mjmokhtar/STM32F407VETx-EC600K-IoT/images/image.png

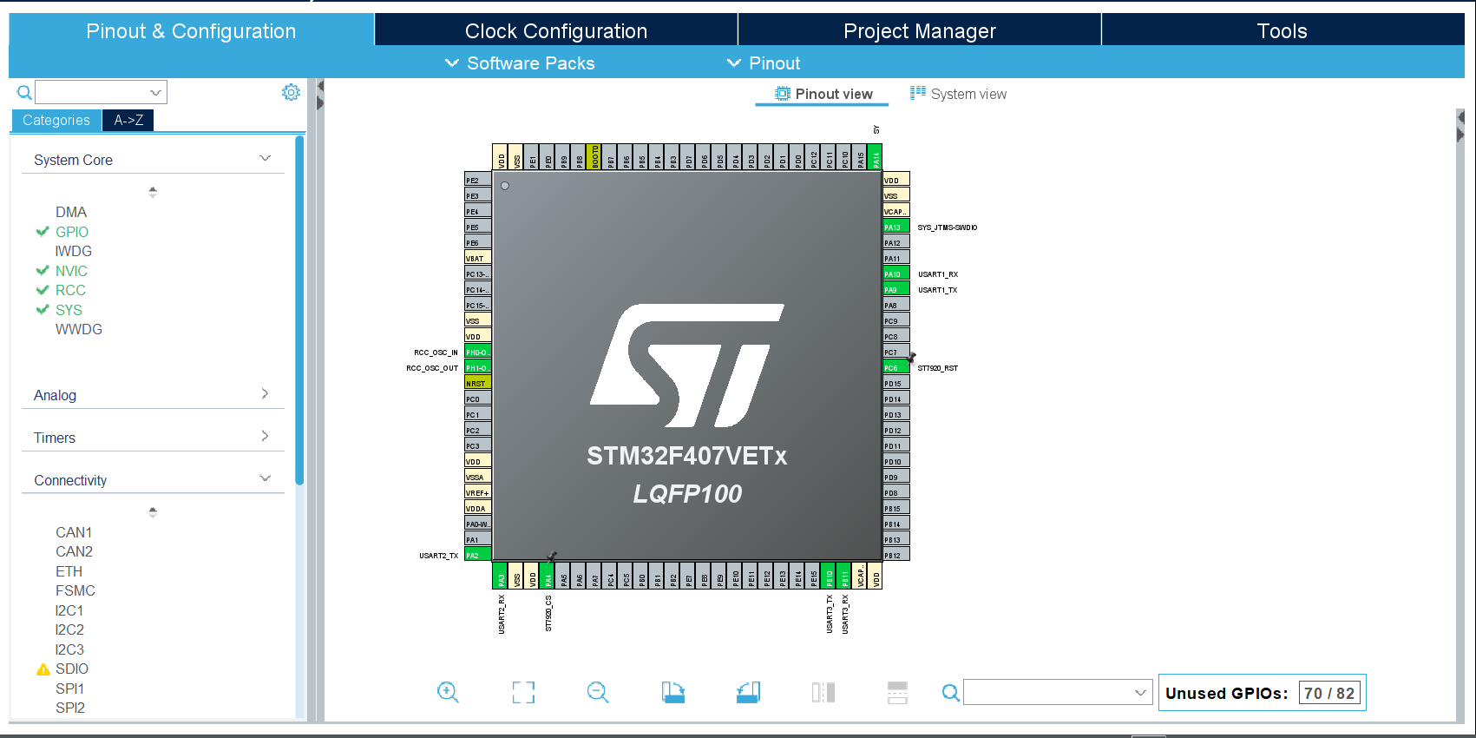
images/image.png
