mjmokhtar/STM32F407VETx-EC600K-IoT/Core/Src/main.c

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
/* Includes ------------------------------------------------------------------*/
#include "main.h"
#include "cmsis_os.h"
#include "sensor.h"
#include "lte_4g.h"
#include <stdio.h>
#include <string.h>

UART_HandleTypeDef huart1;
UART_HandleTypeDef huart2;
UART_HandleTypeDef huart3;

/* Definitions for defaultTask */
//osThreadId_t defaultTaskHandle;
//const osThreadAttr_t defaultTask_attributes = {
//  .name = "defaultTask",
//  .stack_size = 128 * 4,
//  .priority = (osPriority_t) osPriorityNormal,
//};

/* ── Queue ───────────────────────────────────────────────────── */
osMessageQueueId_t sensor_queue;

/* ── Task Attributes ─────────────────────────────────────────── */
const osThreadAttr_t sensor_task_attr = {
    .name       = "sensor_task",
    .stack_size = 512 * 4,
    .priority   = osPriorityAboveNormal,
};

void SystemClock_Config(void);
static void MX_GPIO_Init(void);
static void MX_USART1_UART_Init(void);
static void MX_USART2_UART_Init(void);
static void MX_USART3_UART_Init(void);
//void StartDefaultTask(void *argument);

/* USER CODE BEGIN PFP */
void sensor_task(void *arg);
//void display_task(void *arg);
/* USER CODE END PFP */

/**
  * @brief  The application entry point.
  * @retval int
  */
int main(void)
{

  /* MCU Configuration--------------------------------------------------------*/

  /* Reset of all peripherals, Initializes the Flash interface and the Systick. */
  HAL_Init();

  /* Configure the system clock */
  SystemClock_Config();

  /* Initialize all configured peripherals */
  MX_GPIO_Init();
  MX_USART1_UART_Init();
  MX_USART2_UART_Init();
  MX_USART3_UART_Init();
  /* Init scheduler */
  osKernelInitialize();

  /* USER CODE BEGIN RTOS_MUTEX */
  /* add mutexes, ... */
  /* USER CODE END RTOS_MUTEX */

  /* USER CODE BEGIN RTOS_SEMAPHORES */
  /* add semaphores, ... */
  /* USER CODE END RTOS_SEMAPHORES */

  /* USER CODE BEGIN RTOS_TIMERS */
  /* start timers, add new ones, ... */
  /* USER CODE END RTOS_TIMERS */

  /* USER CODE BEGIN RTOS_QUEUES */
  /* add queues, ... */
  sensor_queue = osMessageQueueNew(1, sizeof(sensor_data_t), NULL);
  /* USER CODE END RTOS_QUEUES */
  osThreadNew(sensor_task,  NULL, &sensor_task_attr);
//    osThreadNew(display_task, NULL, &display_task_attr);
    lte_4g_init();  /* ← tambahkan ini */
  /* Create the thread(s) */
  /* creation of defaultTask */
//  defaultTaskHandle = osThreadNew(StartDefaultTask, NULL, &defaultTask_attributes);

  /* USER CODE BEGIN RTOS_THREADS */
  /* add threads, ... */
  /* USER CODE END RTOS_THREADS */

  /* USER CODE BEGIN RTOS_EVENTS */
  /* add events, ... */
  /* USER CODE END RTOS_EVENTS */

  /* Start scheduler */
  osKernelStart();

  /* We should never get here as control is now taken by the scheduler */

  /* Infinite loop */
  /* USER CODE BEGIN WHILE */
  while (1)
  {
    /* USER CODE END WHILE */

    /* USER CODE BEGIN 3 */
  }
  /* USER CODE END 3 */
}

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
/* USER CODE BEGIN Header_StartDefaultTask */
///**
//  * @brief  Function implementing the defaultTask thread.
//  * @param  argument: Not used
//  * @retval None
//  */
/* USER CODE END Header_StartDefaultTask */
//void StartDefaultTask(void *argument)
//{
  /* USER CODE BEGIN 5 */
////  /* Infinite loop */
////  for(;;)
////  {
////    osDelay(1);
////  }
  /* USER CODE END 5 */
//}

/* ══════════════════════════════════════════════════════════════
 * sensor_task
 * Baca XY-MD02 setiap 5 detik, kirim ke queue
 * ══════════════════════════════════════════════════════════════ */
void sensor_task(void *arg)
{
    sensor_data_t data;
    sensor_init();

    while (1)
    {
        int ret = sensor_read(&data);

        if (ret == SENSOR_OK)
        {
            /* Overwrite queue dengan data terbaru */
            osMessageQueuePut(sensor_queue, &data, 0, 0);
        }
        /* Debug via USART1 */
        char dbg[64];
                snprintf(dbg, sizeof(dbg),
                         "[SENSOR] ret=%d T=%.1f H=%.1f\r\n",
                         ret, data.temperature, data.humidity);
                HAL_UART_Transmit(&huart3, (uint8_t*)dbg, strlen(dbg), 100);

        osDelay(5000);
    }
}


/**
  * @brief  Period elapsed callback in non blocking mode
  * @note   This function is called  when TIM1 interrupt took place, inside
  * HAL_TIM_IRQHandler(). It makes a direct call to HAL_IncTick() to increment
  * a global variable "uwTick" used as application time base.
  * @param  htim : TIM handle
  * @retval None
  */
void HAL_TIM_PeriodElapsedCallback(TIM_HandleTypeDef *htim)
{
  if (htim->Instance == TIM1)
  {
    HAL_IncTick();
  }
}

/**
  * @brief  This function is executed in case of error occurrence.
  * @retval None
  */
void Error_Handler(void)
{
  /* USER CODE BEGIN Error_Handler_Debug */
  /* User can add his own implementation to report the HAL error return state */
  __disable_irq();
  while (1)
  {
  }
  /* USER CODE END Error_Handler_Debug */
}
#ifdef USE_FULL_ASSERT
/**
  * @brief  Reports the name of the source file and the source line number
  *         where the assert_param error has occurred.
  * @param  file: pointer to the source file name
  * @param  line: assert_param error line source number
  * @retval None
  */
void assert_failed(uint8_t *file, uint32_t line)
{
  /* USER CODE BEGIN 6 */
  /* User can add his own implementation to report the file name and line number,
     ex: printf("Wrong parameters value: file %s on line %d\r\n", file, line) */
  /* USER CODE END 6 */
}
#endif /* USE_FULL_ASSERT */
