mjmokhtar/STM32F407VETx-EC600K-IoT/Core/Inc/main.h

#define ST7920_CS_Pin GPIO_PIN_4
#define ST7920_CS_GPIO_Port GPIOA
#define ST7920_RST_Pin GPIO_PIN_6
#define ST7920_RST_GPIO_Port GPIOC
