mjmokhtar/STM32F407VETx-EC600K-IoT/(commit log)

2026-06-01 Add ESP32 EC600K MQTT test code
2026-06-01 Create README.md for EC600K MQTT test setup
    Added detailed README for ESP32 EC600K MQTT testing.
2026-10-01 Add README for STM32F407VETx IoT Monitor
    Added detailed documentation for STM32F407VET6 IoT environment monitor, including hardware, pinout, UART mapping, clock configuration, software stack, and known issues.
